CaioslppUO/Agrobot/src/AppControl/readme.md

# App Control for Agrobot:

  * This app alows you to control the robot using a raspberry pi as a webserver, that receive the information from the app and
    send to the arduino (Using Uart Communication);
    
  * There is a upper box to type an IP. In there, when you and the raspberry are connected to the same network, just type the       rasperry IP and hit OK.
  
  * In the center, there is a joystick to control the robot.
  
  * Down on the screen, there is a bar, it is used to control the limit of the robot(0 - 100%).
