CaioslppUO/Agrobot/pictures/circuits/mainCircuit/readme.md

# This section is about the mainCircuit:

   * Be careful not to use the main board 15v wire(red cable), it can burn both arduino and raspberry.
   * Both arduino and raspberry are powered by a 5v source via USB.

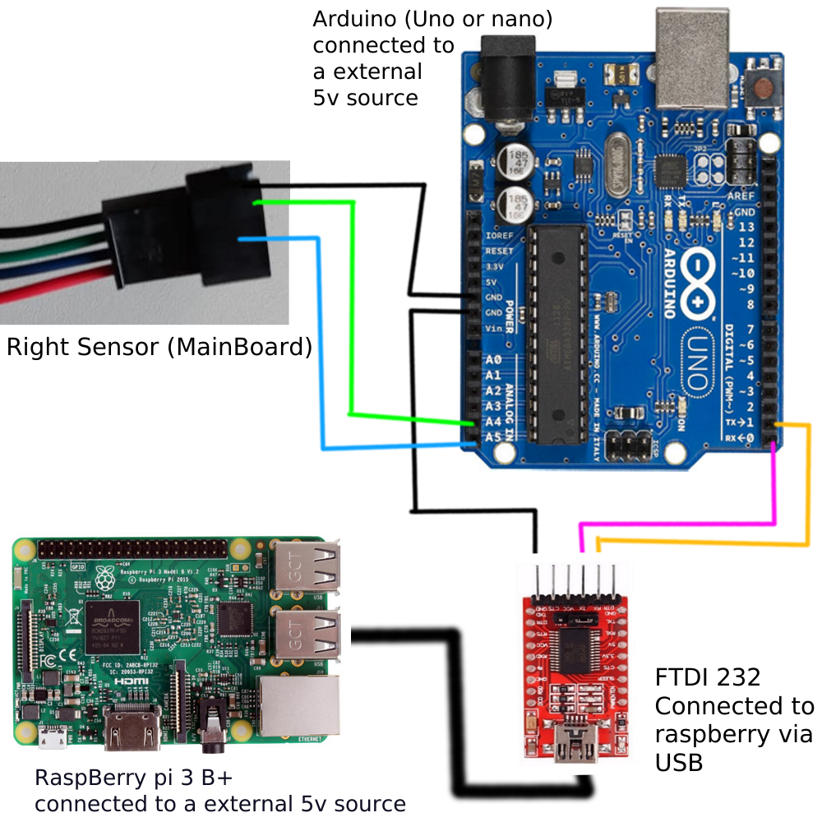
[picture p4: pictures/circuits/mainCircuit/mainCircuit.png]
mainCircuit
