CaioslppUO/Agrobot/pictures/robot/readme.md

This section have some pictures of the robot:

robo1

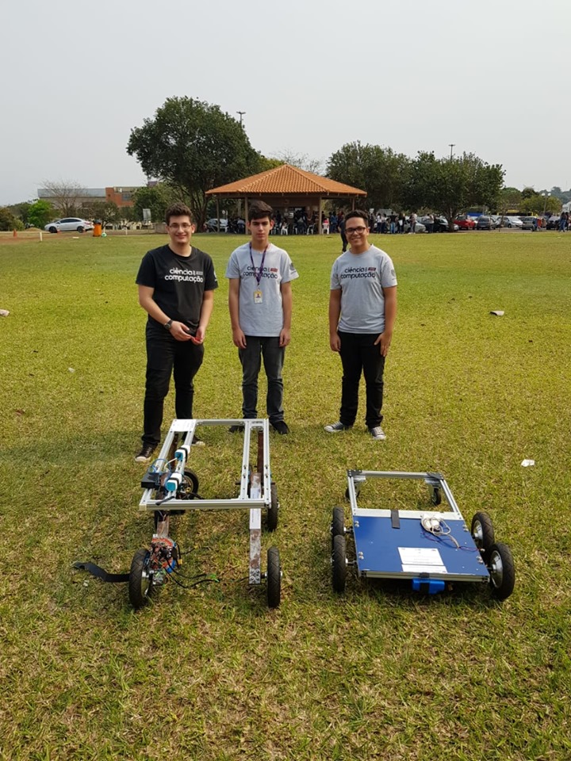
[picture p6: pictures/robot/robo2.jpg]
robo2
